Arav0001/navion-dev/(list of files, drawings)

Other design files:
Schematics/CNTRL/freerouting.dsn
Schematics/CNTRL/temp-freerouting.dsn
