Arav0001/navion-dev/Schematics/CNTRL/CNTRL.kicad_pcb

## KiCad design Schematics/CNTRL/CNTRL.kicad_pcb (2025-07-29)

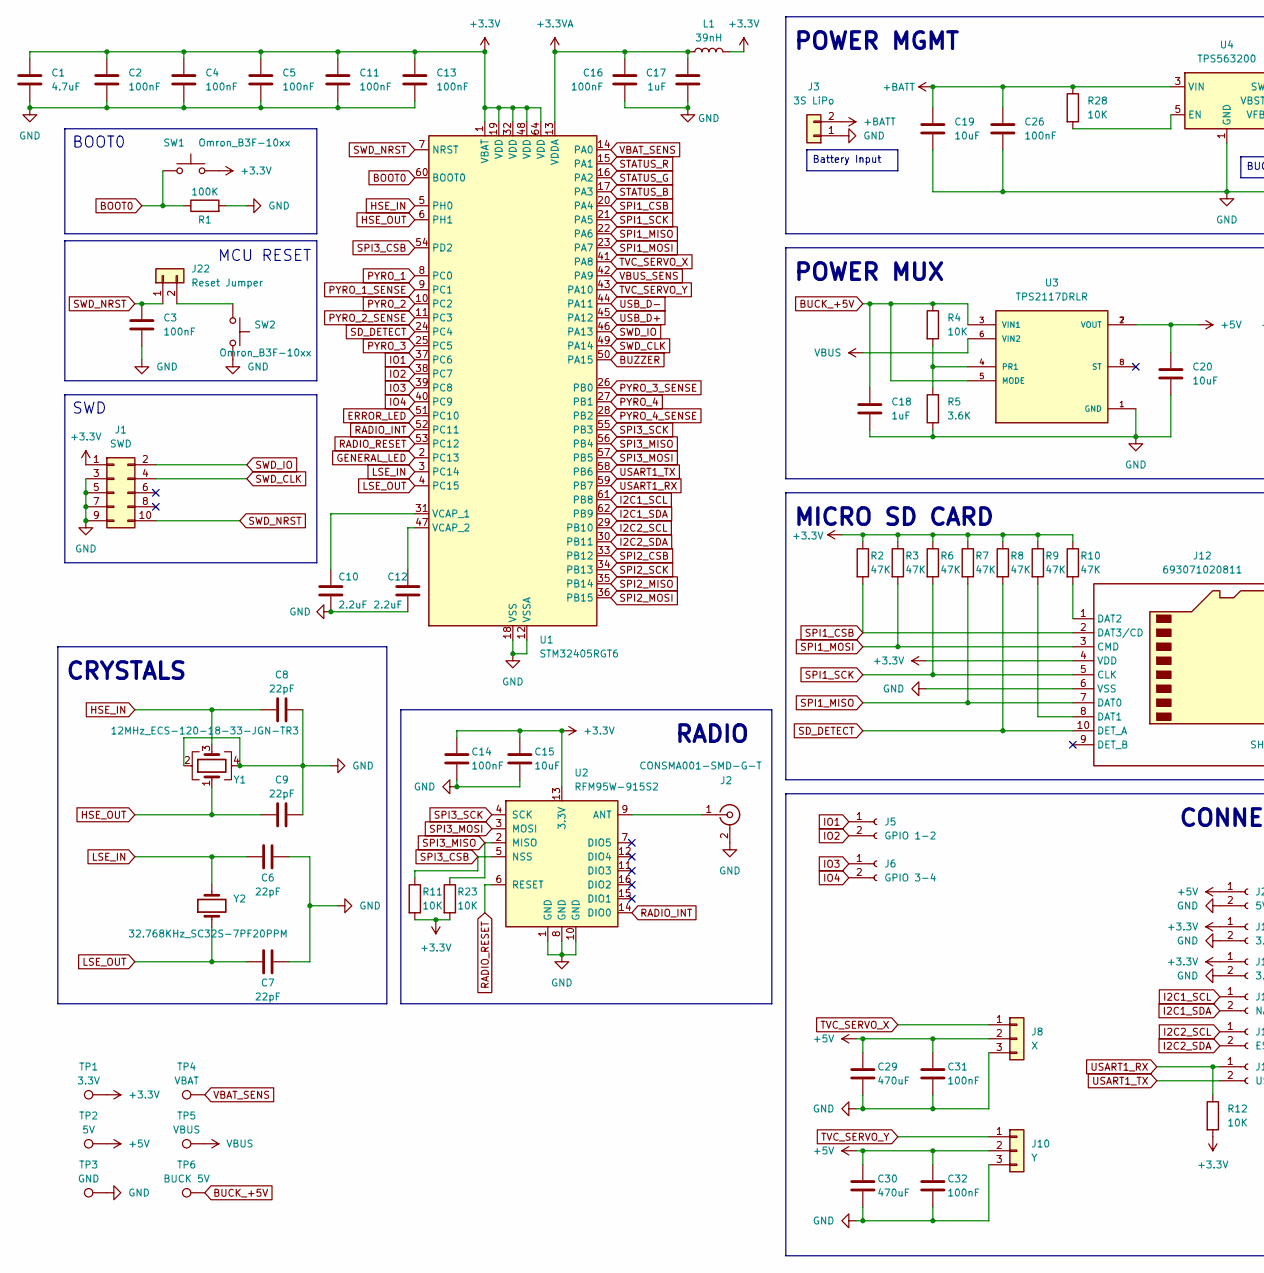
[picture p1: schematic CNTRL.kicad_sch, NAVION CNTRL BOARD SCHEMATIC, part in row 1, column 1]

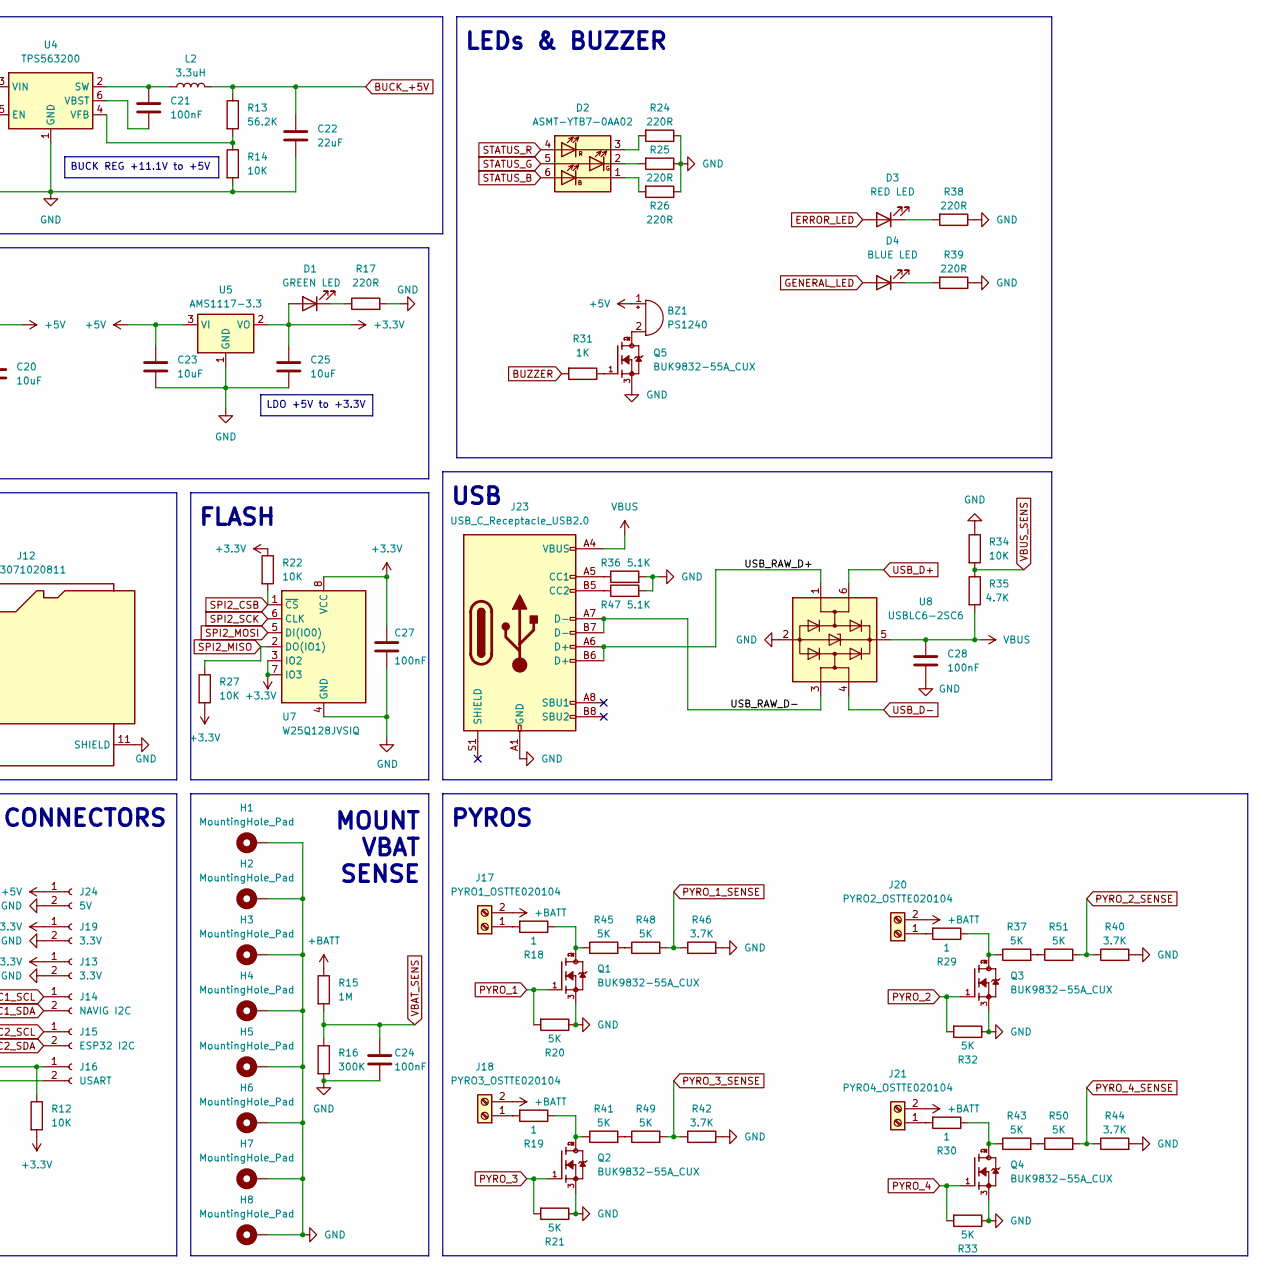
[picture p2: schematic CNTRL.kicad_sch, NAVION CNTRL BOARD SCHEMATIC, part in row 1, column 2]

Parts:
BZ1: PS1240; Buzzer_TDK_PS1240P02BT_D12.2mm_H6.5mm
C1: 4.7uF; C_0603_1608Metric
C2, C3, C4, C5, C11, C13, C14, C16, C21, C24, C26, C27, C28, C31, C32: 100nF; C_0603_1608Metric
C6, C7, C8, C9: 22pF; C_0603_1608Metric
C10, C12: 2.2uF; C_0603_1608Metric
C15, C19, C20, C23, C25: 10uF; C_0603_1608Metric
C17, C18: 1uF; C_0603_1608Metric
C22: 22uF; C_0603_1608Metric
C29, C30: 470uF; CP_Radial_D6.3mm_P2.50mm
D1: GREEN LED; LED_0603_1608Metric
D2: ASMT-YTB7-0AA02; LED_Avago_PLCC6_3x2.8mm
D3: RED LED; LED_0603_1608Metric
D4: BLUE LED; LED_0603_1608Metric
H1, H2, H3, H4, H5, H6, H7, H8: MountingHole_Pad; MountingHole_2.2mm_M2_Pad_TopBottom
J1: SWD; PinHeader_2x05_P1.27mm_Vertical_SMD
J2: CONSMA001-SMD-G-T; LINX_CONSMA001-SMD-G-T
J3: 3S LiPo; AMASS_XT30UPB-M_1x02_P5.0mm_Vertical
J5: GPIO 1-2; TerminalBlock_Phoenix_MPT-0,5-2-2.54_1x02_P2.54mm_Horizontal
J6: GPIO 3-4; TerminalBlock_Phoenix_MPT-0,5-2-2.54_1x02_P2.54mm_Horizontal
J8: X; TerminalBlock_Phoenix_MPT-0,5-3-2.54_1x03_P2.54mm_Horizontal
J10: Y; TerminalBlock_Phoenix_MPT-0,5-3-2.54_1x03_P2.54mm_Horizontal
J12: 693071020811
J13, J19: 3.3V; JST_XH_B2B-XH-A_1x02_P2.50mm_Vertical
J14: NAVIG I2C; JST_XH_B2B-XH-A_1x02_P2.50mm_Vertical
J15: ESP32 I2C; JST_XH_B2B-XH-A_1x02_P2.50mm_Vertical
J16: USART; JST_XH_B2B-XH-A_1x02_P2.50mm_Vertical
J17: PYRO1_OSTTE020104; TerminalBlock_4Ucon_1x02_P3.50mm_Vertical
J18: PYRO3_OSTTE020104; TerminalBlock_4Ucon_1x02_P3.50mm_Vertical
J20: PYRO2_OSTTE020104; TerminalBlock_4Ucon_1x02_P3.50mm_Vertical
J21: PYRO4_OSTTE020104; TerminalBlock_4Ucon_1x02_P3.50mm_Vertical
J22: Reset Jumper; PinHeader_1x02_P2.54mm_Vertical
J23: USB_C_Receptacle_USB2.0; USB_C_Receptacle_GCT_USB4105-xx-A_16P_TopMnt_Horizontal
J24: 5V; JST_XH_B2B-XH-A_1x02_P2.50mm_Vertical
L1: 39nH; L_0603_1608Metric
L2: 3.3uH; L_1210_3225Metric_Pad1.42x2.65mm_HandSolder
Q1, Q2, Q3, Q4, Q5: BUK9832-55A_CUX; TRANS_BUK9832-55A_CUX; PARTREV 02
R1: 100K; R_0603_1608Metric
R2, R3, R6, R7, R8, R9, R10: 47K; R_0603_1608Metric
R4, R11, R12, R14, R22, R23, R27, R28, R34: 10K; R_0603_1608Metric
R5: 3.6K; R_0603_1608Metric
R13: 56.2K; R_0603_1608Metric
R15: 1M; R_0603_1608Metric
R16: 300K; R_0603_1608Metric
R17, R24, R25, R26, R38, R39: 220R; R_0603_1608Metric
R18, R19, R29, R30: 1; R_0603_1608Metric
R20, R21, R32, R33, R37, R41, R43, R45, R48, R49, R50, R51: 5K; R_0603_1608Metric
R31: 1K; R_0603_1608Metric
R35: 4.7K; R_0603_1608Metric
R36, R47: 5.1K; R_0603_1608Metric
R40, R42, R44, R46: 3.7K; R_0603_1608Metric
SW1, SW2: Omron_B3F-10xx; SW_TH_Tactile_Omron_B3F-10xx
TP1: 3.3V; TestPoint_Pad_D2.0mm
TP2: 5V; TestPoint_Pad_D2.0mm
TP3: GND; TestPoint_Pad_D2.0mm
TP4: VBAT; TestPoint_Pad_D2.0mm
TP5: VBUS; TestPoint_Pad_D2.0mm
TP6: BUCK 5V; TestPoint_Pad_D2.0mm
U1: STM32405RGT6; LQFP-64_10x10mm_P0.5mm
U2: RFM95W-915S2; HOPERF_RFM9XW_SMD
U3: TPS2117DRLR; SOT-583-8; PARTREV A
U4: TPS563200; SOT-23-6
U5: AMS1117-3.3; SOT-223-3_TabPin2
U7: W25Q128JVSIQ; SOIC-8_5.3x5.3mm_P1.27mm
U8: USBLC6-2SC6; SOT-23-6
Y1: 12MHz_ECS-120-18-33-JGN-TR3; Crystal_SMD_3225-4Pin_3.2x2.5mm
Y2: 32.768KHz_SC32S-7PF20PPM; Crystal_SMD_3215-2Pin_3.2x1.5mm

Connections:
+3.3V: C1.1, C2.1, C4.1, C5.1, C11.1, C13.1, C14.2, C15.2, C25.1, C27.1, D1.2 (A), J1.1, J12.4 (VDD), J13.1, J19.1, L1.1, R2.1, R3.1, R6.1, R7.1, R8.1, R9.1, R10.1, R11.2, R12.2, R22.1, R23.2, R27.2, SW1.2, TP1.1, U1.1 (VBAT), U1.19 (VDD), U1.32 (VDD), U1.48 (VDD), U1.64 (VDD), U2.13 (3.3V), U5.2 (VO), U7.3 (IO2), U7.7 (IO3), U7.8 (VCC)
+3.3VA: C16.1, C17.1, L1.2, U1.13 (VDDA)
+5V: BZ1.1 (-), C20.1, C23.1, C29.2, C30.2, C31.2, C32.2, J8.2, J10.2, J24.1, TP2.1, U3.2 (VOUT), U3.7 (VOUT), U5.3 (VI)
+BATT: C19.1, C26.1, J3.2, J17.2, J18.2, J20.2, J21.2, R15.1, R28.1, U4.3 (VIN)
/USB_RAW_D+: J23.A6 (D+), J23.B6 (D+), U8.1 (I/O1)
/USB_RAW_D-: J23.A7 (D-), J23.B7 (D-), U8.3 (I/O2)
BOOT0: R1.1, SW1.1, U1.60 (BOOT0)
BUCK_+5V: C18.1, C22.1, L2.2, R4.1, R13.1, TP6.1, U3.3 (VIN1), U3.5 (MODE)
BUZZER: R31.2, U1.50 (PA15)
ERROR_LED: D3.2 (A), U1.51 (PC10)
GENERAL_LED: D4.2 (A), U1.2 (PC13)
GND: C1.2, C2.2, C3.2, C4.2, C5.2, C6.2, C7.2, C8.1, C9.2, C10.1, C11.2, C12.1, C13.2, C14.1, C15.1, C16.2, C17.2, C18.2, C19.2, C20.2, C22.2, C23.2, C24.1, C25.2, C26.2, C27.2, C28.2, C29.1, C30.1, C31.1, C32.1, H1.1, H2.1, H3.1, H4.1, H5.1, H6.1, H7.1, H8.1, J1.3, J1.5, J1.7, J1.9, J2.2 (Ext), J3.1, J8.3, J10.3, J12.6 (VSS), J12.11 (SHIELD), J13.2, J19.2, J23.A1 (GND), J23.A12 (GND), J23.B1 (GND), J23.B12 (GND), J24.2, Q1.3, Q2.3, Q3.3, Q4.3, Q5.3, R1.2, R5.1, R14.2, R16.2, R17.2, R20.1, R21.1, R24.1, R25.1, R26.1, R32.1, R33.1, R34.1, R36.2, R38.1, R39.1, R40.2, R42.2, R44.2, R46.2, R47.2, SW2.2, TP3.1, U1.12 (VSSA), U1.18 (VSS), U1.63 (VSS), U2.1 (GND), U2.8 (GND), U2.10 (GND), U3.1 (GND), U4.1 (GND), U5.1 (GND), U7.4 (GND), U8.2 (GND), Y1.2, Y1.4
HSE_IN: C8.2, U1.5 (PH0), Y1.3
HSE_OUT: C9.1, U1.6 (PH1), Y1.1
I2C1_SCL: J14.1, U1.61 (PB8)
I2C1_SDA: J14.2, U1.62 (PB9)
I2C2_SCL: J15.1, U1.29 (PB10)
I2C2_SDA: J15.2, U1.30 (PB11)
IO1: J5.1, U1.37 (PC6)
IO2: J5.2, U1.38 (PC7)
IO3: J6.1, U1.39 (PC8)
IO4: J6.2, U1.40 (PC9)
LSE_IN: C6.1, U1.3 (PC14), Y2.2
LSE_OUT: C7.1, U1.4 (PC15), Y2.1
unnamed: BZ1.2 (+), Q5.2, Q5.4
unnamed: D1.1 (K), R17.1
unnamed: D2.1 (KB), R26.2
unnamed: D2.2 (KG), R25.2
unnamed: D2.3 (KR), R24.2
unnamed: D3.1 (K), R38.2
unnamed: D4.1 (K), R39.2
unnamed: J2.1 (In), U2.9 (ANT)
unnamed: J12.8 (DAT1), R9.2
unnamed: J12.1 (DAT2), R10.2
unnamed: J17.1, R18.2
unnamed: J18.1, R19.2
unnamed: J20.1, R29.2
unnamed: J21.1, R30.2
unnamed: J22.2, SW2.1
unnamed: J23.A5 (CC1), R36.1
unnamed: J23.B5 (CC2), R47.1
unnamed: Q1.2, Q1.4, R18.1, R45.1
unnamed: Q2.2, Q2.4, R19.1, R41.1
unnamed: Q3.2, Q3.4, R29.1, R37.1
unnamed: Q4.2, Q4.4, R30.1, R43.1
unnamed: Q5.1, R31.1
unnamed: R37.2, R51.1
unnamed: R41.2, R49.1
unnamed: R43.2, R50.1
unnamed: R45.2, R48.1
unnamed: C10.2, U1.31 (VCAP_1)
unnamed: C12.2, U1.47 (VCAP_2)
unnamed: R4.2, R5.2, U3.4 (PR1)
unnamed: R28.2, U4.5 (EN)
unnamed: C21.1, L2.1, U4.2 (SW)
unnamed: C21.2, U4.6 (VBST)
unnamed: R13.2, R14.1, U4.4 (VFB)
PYRO_1: Q1.1, R20.2, U1.8 (PC0)
PYRO_1_SENSE: R46.1, R48.2, U1.9 (PC1)
PYRO_2: Q3.1, R32.2, U1.10 (PC2)
PYRO_2_SENSE: R40.1, R51.2, U1.11 (PC3)
PYRO_3: Q2.1, R21.2, U1.25 (PC5)
PYRO_3_SENSE: R42.1, R49.2, U1.26 (PB0)
PYRO_4: Q4.1, R33.2, U1.27 (PB1)
PYRO_4_SENSE: R44.1, R50.2, U1.28 (PB2)
RADIO_INT: U1.52 (PC11), U2.14 (DIO0)
RADIO_RESET: U1.53 (PC12), U2.6 (RESET)
SD_DETECT: J12.10 (DET_A), R8.2, U1.24 (PC4)
SPI1_CSB: J12.2 (DAT3/CD), R2.2, U1.20 (PA4)
SPI1_MISO: J12.7 (DAT0), R7.2, U1.22 (PA6)
SPI1_MOSI: J12.3 (CMD), R3.2, U1.23 (PA7)
SPI1_SCK: J12.5 (CLK), R6.2, U1.21 (PA5)
SPI2_CSB: R22.2, U1.33 (PB12), U7.1 (~CS)
SPI2_MISO: R27.1, U1.35 (PB14), U7.2 (DO(IO1))
SPI2_MOSI: U1.36 (PB15), U7.5 (DI(IO0))
SPI2_SCK: U1.34 (PB13), U7.6 (CLK)
SPI3_CSB: R11.1, U1.54 (PD2), U2.5 (NSS)
SPI3_MISO: R23.1, U1.56 (PB4), U2.2 (MISO)
SPI3_MOSI: U1.57 (PB5), U2.3 (MOSI)
SPI3_SCK: U1.55 (PB3), U2.4 (SCK)
STATUS_B: D2.6 (AB), U1.17 (PA3)
STATUS_G: D2.5 (AG), U1.16 (PA2)
STATUS_R: D2.4 (AR), U1.15 (PA1)
SWD_CLK: J1.4, U1.49 (PA14)
SWD_IO: J1.2, U1.46 (PA13)
SWD_NRST: C3.1, J1.10, J22.1, U1.7 (NRST)
TVC_SERVO_X: J8.1, U1.41 (PA8)
TVC_SERVO_Y: J10.1, U1.43 (PA10)
USART1_RX: J16.1, R12.1, U1.59 (PB7)
USART1_TX: J16.2, U1.58 (PB6)
USB_D+: U1.45 (PA12), U8.6 (I/O1)
USB_D-: U1.44 (PA11), U8.4 (I/O2)
VBAT_SENS: C24.2, R15.2, R16.1, TP4.1, U1.14 (PA0)
VBUS: C28.1, J23.A4 (VBUS), J23.A9 (VBUS), J23.B4 (VBUS), J23.B9 (VBUS), R35.2, TP5.1, U3.6 (VIN2), U8.5 (VBUS)
VBUS_SENS: R34.2, R35.1, U1.42 (PA9)

Notes on the sheet:
CONNECTORS
PYROS
BOOT0
POWER MUX
SWD
FLASH
LEDs & BUZZER
MCU RESET
MOUNT VBAT SENSE
CRYSTALS
MICRO SD CARD
POWER MGMT
RADIO
USB
Battery Input
LDO +5V to +3.3V
BUCK REG +11.1V to +5V

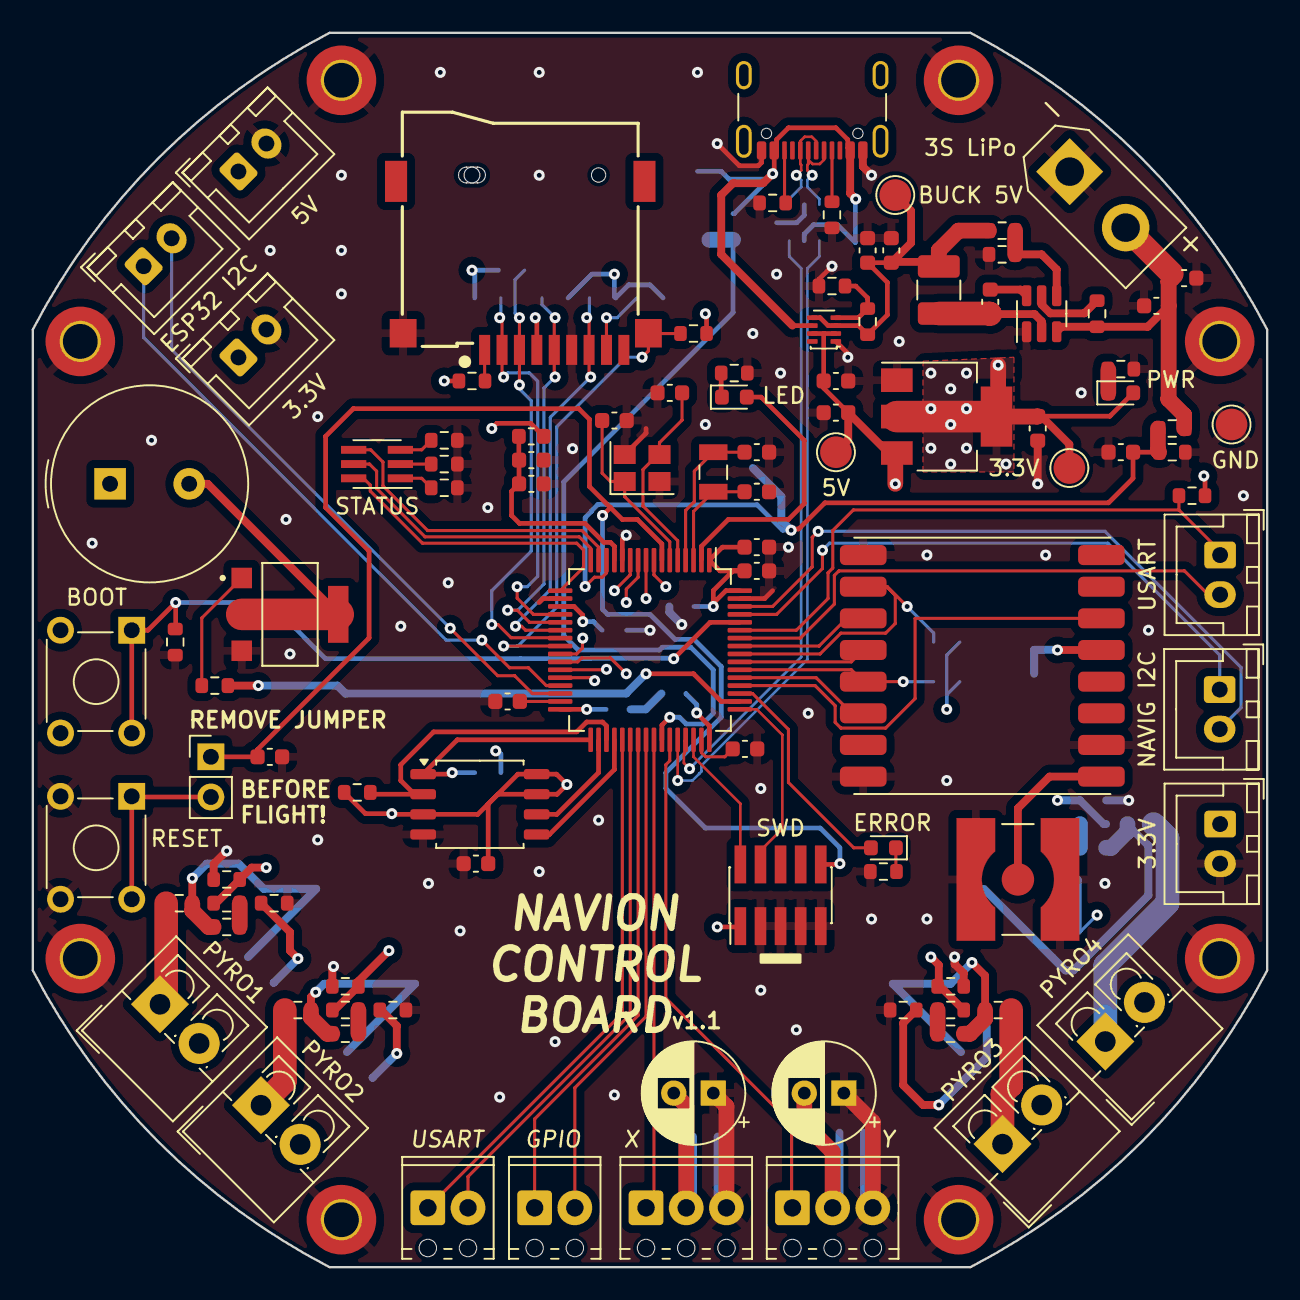
[picture p3: board CNTRL.kicad_pcb from above]

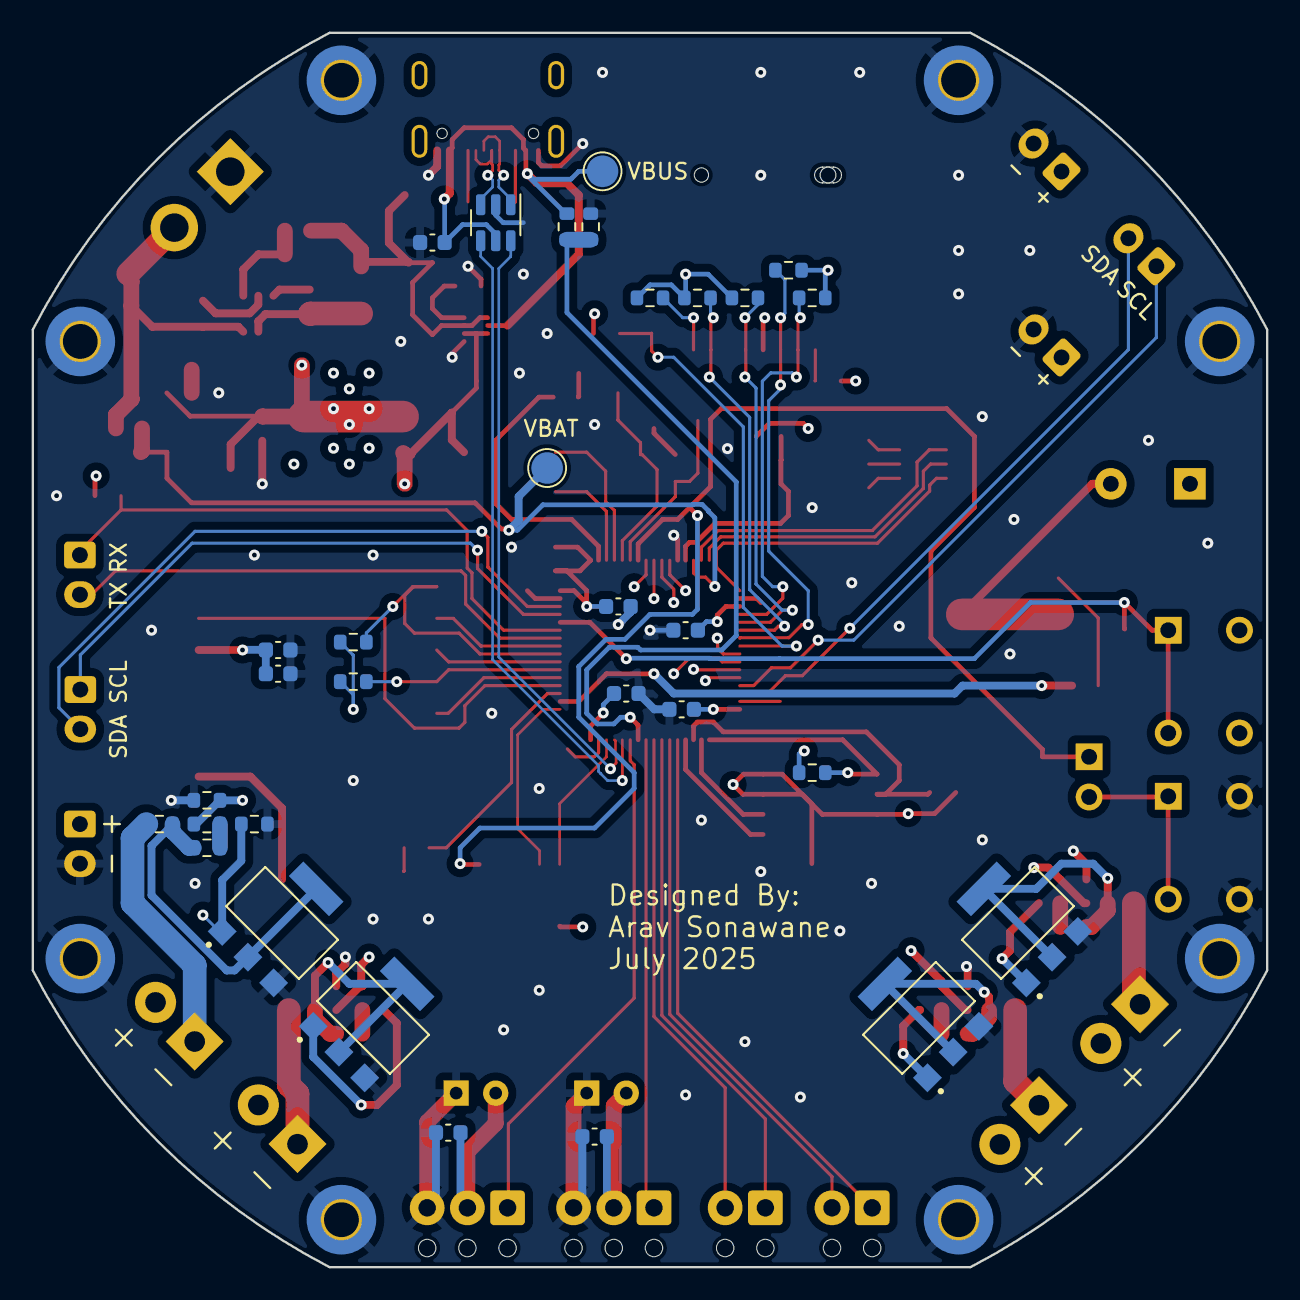
[picture p4: board CNTRL.kicad_pcb from below]

Board: 4 copper layers, 78.0 x 78.0 mm, 140 parts (31 on the bottom side), 95 nets.
