Arav0001/navion-dev/Schematics/NAVIG/NAVIG.kicad_pcb

## KiCad design Schematics/NAVIG/NAVIG.kicad_pcb (2025-07-29)

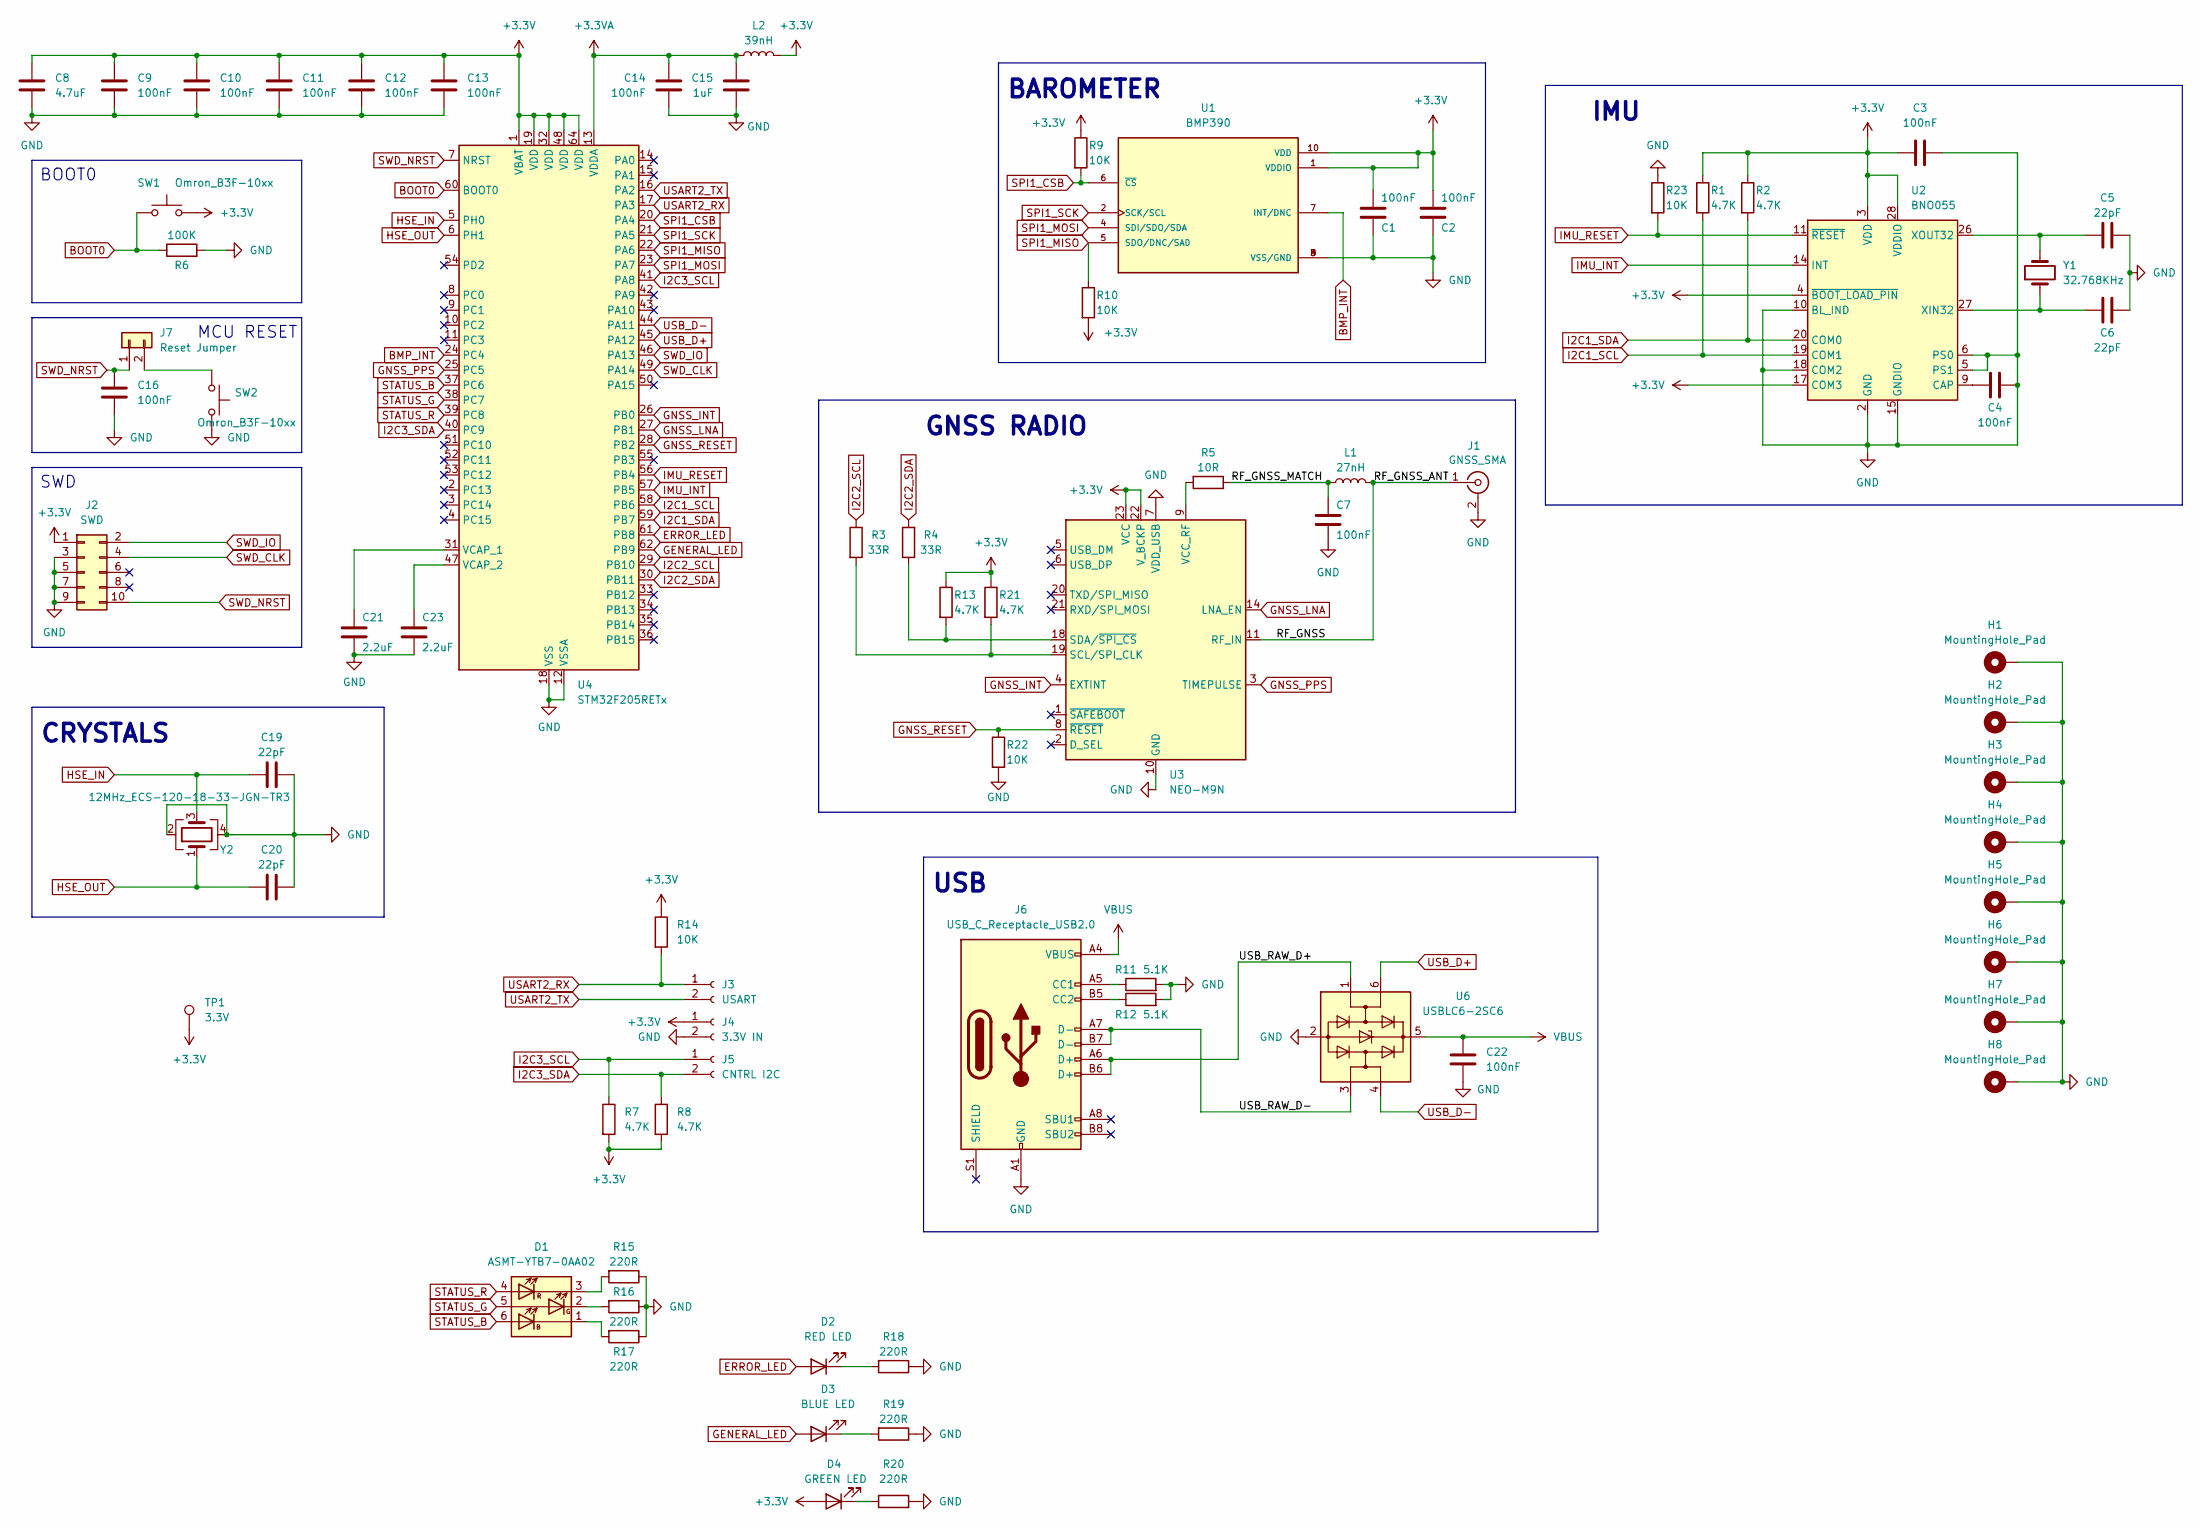
[picture p5: schematic NAVIG.kicad_sch]

Parts:
C1, C2, C3, C4, C7, C9, C10, C11, C12, C13, C14, C16, C22: 100nF; C_0603_1608Metric
C5, C6, C19, C20: 22pF; C_0603_1608Metric
C8: 4.7uF; C_0603_1608Metric
C15: 1uF; C_0603_1608Metric
C21, C23: 2.2uF; C_0603_1608Metric
D1: ASMT-YTB7-0AA02; LED_Avago_PLCC6_3x2.8mm
D2: RED LED; LED_0603_1608Metric
D3: BLUE LED; LED_0603_1608Metric
D4: GREEN LED; LED_0603_1608Metric
H1, H2, H3, H4, H5, H6, H7, H8: MountingHole_Pad; MountingHole_2.2mm_M2_Pad_TopBottom
J1: GNSS_SMA; SMA_Amphenol_132134-10_Vertical
J2: SWD; PinHeader_2x05_P1.27mm_Vertical_SMD
J3: USART; JST_XH_B2B-XH-A_1x02_P2.50mm_Vertical
J4: 3.3V IN; JST_XH_B2B-XH-A_1x02_P2.50mm_Vertical
J5: CNTRL I2C; JST_XH_B2B-XH-A_1x02_P2.50mm_Vertical
J6: USB_C_Receptacle_USB2.0; USB_C_Receptacle_GCT_USB4105-xx-A_16P_TopMnt_Horizontal
J7: Reset Jumper; PinHeader_1x02_P2.54mm_Vertical
L1: 27nH; L_TDK_NLV32_3.2x2.5mm
L2: 39nH; L_0603_1608Metric
R1, R2, R7, R8, R13, R21: 4.7K; R_0603_1608Metric
R3, R4: 33R; R_0603_1608Metric
R5: 10R; R_0603_1608Metric
R6: 100K; R_0603_1608Metric
R9, R10, R14, R22, R23: 10K; R_0603_1608Metric
R11, R12: 5.1K; R_0603_1608Metric
R15, R16, R17, R18, R19, R20: 220R; R_0603_1608Metric
SW1, SW2: Omron_B3F-10xx; SW_TH_Tactile_Omron_B3F-10xx
TP1: 3.3V; TestPoint_Pad_D2.0mm
U1: BMP390; XDCR_BMP390L; PARTREV 1.7
U2: BNO055; LGA-28_5.2x3.8mm_P0.5mm
U3: NEO-M9N; ublox_NEO
U4: STM32F205RETx; LQFP-64_10x10mm_P0.5mm
U6: USBLC6-2SC6; SOT-23-6
Y1: 32.768KHz; Crystal_SMD_3215-2Pin_3.2x1.5mm
Y2: 12MHz_ECS-120-18-33-JGN-TR3; Crystal_SMD_3225-4Pin_3.2x2.5mm

Connections:
+3.3V: C1.1, C2.1, C3.2, C8.1, C9.1, C10.1, C11.1, C12.1, C13.1, D4.2 (A), J2.1, J4.1, L2.1, R1.1, R2.1, R7.2, R8.2, R9.1, R10.2, R13.1, R14.1, R21.1, SW1.2, TP1.1, U1.1 (VDDIO), U1.10 (VDD), U2.3 (VDD), U2.4 (~BOOT_LOAD_PIN), U2.17 (COM3), U2.28 (VDDIO), U3.22 (V_BCKP), U3.23 (VCC), U4.1 (VBAT), U4.19 (VDD), U4.32 (VDD), U4.48 (VDD), U4.64 (VDD)
+3.3VA: C14.1, C15.1, L2.2, U4.13 (VDDA)
/RF_GNSS: J1.1 (In), L1.1, U3.11 (RF_IN)
/RF_GNSS_MATCH: C7.1, L1.2, R5.1
/USB_RAW_D+: J6.A6 (D+), J6.B6 (D+), U6.1 (I/O1)
/USB_RAW_D-: J6.A7 (D-), J6.B7 (D-), U6.3 (I/O2)
BMP_INT: U1.7 (INT/DNC), U4.24 (PC4)
BOOT0: R6.1, SW1.1, U4.60 (BOOT0)
ERROR_LED: D2.2 (A), U4.61 (PB8)
GENERAL_LED: D3.2 (A), U4.62 (PB9)
GND: C1.2, C2.2, C3.1, C4.1, C5.2, C6.2, C7.2, C8.2, C9.2, C10.2, C11.2, C12.2, C13.2, C14.2, C15.2, C16.2, C19.1, C20.2, C21.1, C22.2, C23.1, H1.1, H2.1, H3.1, H4.1, H5.1, H6.1, H7.1, H8.1, J1.2 (Ext), J2.3, J2.5, J2.7, J2.9, J4.2, J6.A1 (GND), J6.A12 (GND), J6.B1 (GND), J6.B12 (GND), R6.2, R11.2, R12.2, R15.1, R16.1, R17.1, R18.1, R19.1, R20.2, R22.2, R23.1, SW2.2, U1.3 (VSS/GND), U1.8 (VSS/GND), U1.9 (VSS/GND), U2.2 (GND), U2.5 (PS1), U2.6 (PS0), U2.10 (BL_IND), U2.15 (GNDIO), U2.16 (GNDIO), U2.18 (COM2), U2.25 (GNDIO), U3.7 (VDD_USB), U3.10 (GND), U3.12 (GND), U3.13 (GND), U3.24 (GND), U4.12 (VSSA), U4.18 (VSS), U4.63 (VSS), U6.2 (GND), Y2.2, Y2.4
GNSS_INT: U3.4 (EXTINT), U4.26 (PB0)
GNSS_LNA: U3.14 (LNA_EN), U4.27 (PB1)
GNSS_PPS: U3.3 (TIMEPULSE), U4.25 (PC5)
GNSS_RESET: R22.1, U3.8 (~RESET), U4.28 (PB2)
HSE_IN: C19.2, U4.5 (PH0), Y2.3
HSE_OUT: C20.1, U4.6 (PH1), Y2.1
I2C1_SCL: R1.2, U2.19 (COM1), U4.58 (PB6)
I2C1_SDA: R2.2, U2.20 (COM0), U4.59 (PB7)
I2C2_SCL: R3.1, U4.29 (PB10)
I2C2_SDA: R4.2, U4.30 (PB11)
I2C3_SCL: J5.1, R7.1, U4.41 (PA8)
I2C3_SDA: J5.2, R8.1, U4.40 (PC9)
IMU_INT: U2.14 (INT), U4.57 (PB5)
IMU_RESET: R23.2, U2.11 (~RESET), U4.56 (PB4)
unnamed: D1.1 (KB), R17.2
unnamed: D1.2 (KG), R16.2
unnamed: D1.3 (KR), R15.2
unnamed: D2.1 (K), R18.2
unnamed: D3.1 (K), R19.2
unnamed: D4.1 (K), R20.1
unnamed: J6.A5 (CC1), R11.1
unnamed: J6.B5 (CC2), R12.1
unnamed: J7.2, SW2.1
unnamed: C4.2, U2.9 (CAP)
unnamed: C6.1, U2.27 (XIN32), Y1.1
unnamed: C5.1, U2.26 (XOUT32), Y1.2
unnamed: R3.2, R21.2, U3.19 (SCL/SPI_CLK)
unnamed: R4.1, R13.2, U3.18 (SDA/~SPI_CS)
unnamed: R5.2, U3.9 (VCC_RF)
unnamed: C21.2, U4.31 (VCAP_1)
unnamed: C23.2, U4.47 (VCAP_2)
SPI1_CSB: R9.2, U1.6 (~CS), U4.20 (PA4)
SPI1_MISO: R10.1, U1.5 (SDO/DNC/SA0), U4.22 (PA6)
SPI1_MOSI: U1.4 (SDI/SDO/SDA), U4.23 (PA7)
SPI1_SCK: U1.2 (SCK/SCL), U4.21 (PA5)
STATUS_B: D1.6 (AB), U4.37 (PC6)
STATUS_G: D1.5 (AG), U4.38 (PC7)
STATUS_R: D1.4 (AR), U4.39 (PC8)
SWD_CLK: J2.4, U4.49 (PA14)
SWD_IO: J2.2, U4.46 (PA13)
SWD_NRST: C16.1, J2.10, J7.1, U4.7 (NRST)
USART2_RX: J3.1, R14.2, U4.17 (PA3)
USART2_TX: J3.2, U4.16 (PA2)
USB_D+: U4.45 (PA12), U6.6 (I/O1)
USB_D-: U4.44 (PA11), U6.4 (I/O2)
VBUS: C22.1, J6.A4 (VBUS), J6.A9 (VBUS), J6.B4 (VBUS), J6.B9 (VBUS), U6.5 (VBUS)

Notes on the sheet:
IMU
GNSS RADIO
SWD
USB
CRYSTALS
BOOT0
MCU RESET
BAROMETER

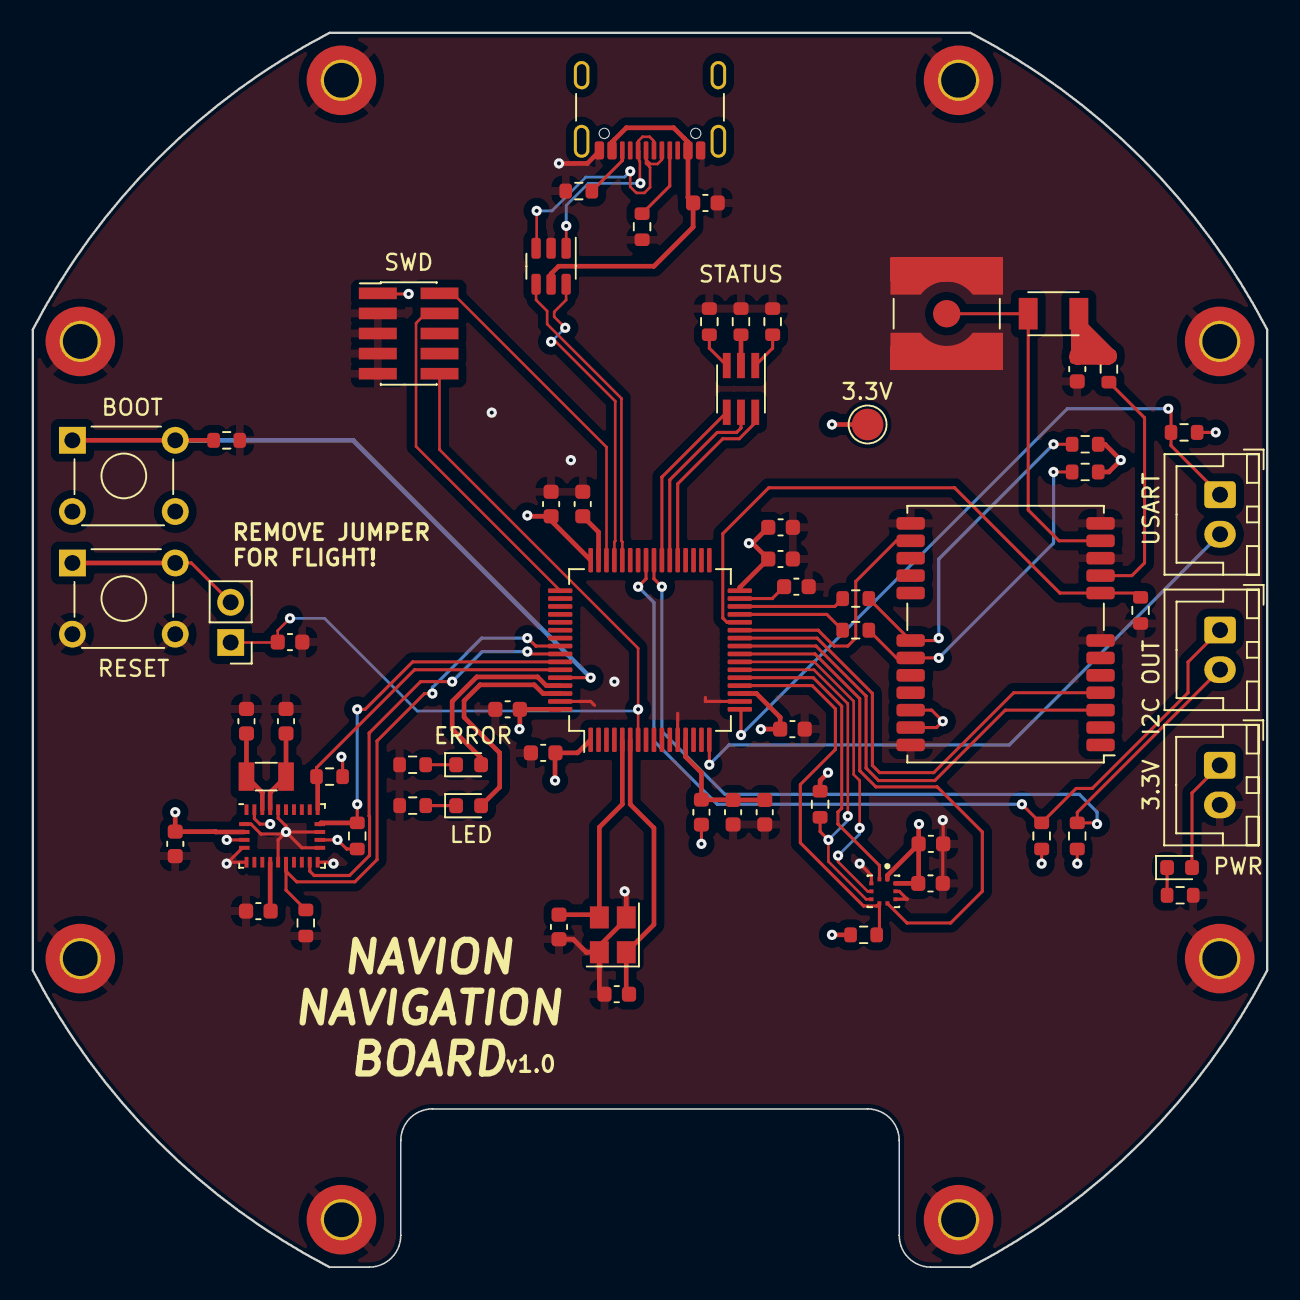
[picture p6: board NAVIG.kicad_pcb from above]

Board: 4 copper layers, 78.0 x 78.0 mm, 75 parts (0 on the bottom side), 57 nets.
