Arav0001/navion-dev/Code/CNTRL/Core/Src/main.c

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
/* Includes ------------------------------------------------------------------*/
#include "main.h"
#include "fatfs.h"
#include "usb_device.h"

/* USER CODE BEGIN Includes */
#include "config.h"
#include "util.h"

#include "usbd_cdc_if.h"

#include "Drivers/pwm.h"
#include "Drivers/led.h"
#include "Drivers/servo.h"
#include "Drivers/pyro.h"
#include "Drivers/w25qxx.h"
#include "Drivers/buzzer.h"

#include "uart_dma.h"
#include "logger.h"
#include "calibration.h"
#include "orientation.h"
#include "tvc.h"
#include "control.h"
#include "battery.h"
#include "esp32.h"
#include "flight.h"
/* USER CODE END Includes */

ADC_HandleTypeDef hadc1;
DMA_HandleTypeDef hdma_adc1;

CRC_HandleTypeDef hcrc;

I2C_HandleTypeDef hi2c1;
I2C_HandleTypeDef hi2c2;

SPI_HandleTypeDef hspi1;
SPI_HandleTypeDef hspi2;
SPI_HandleTypeDef hspi3;

TIM_HandleTypeDef htim1;
TIM_HandleTypeDef htim2;
TIM_HandleTypeDef htim6;
TIM_HandleTypeDef htim7;

UART_HandleTypeDef huart1;
DMA_HandleTypeDef hdma_usart1_rx;

/* USER CODE BEGIN PV */
/* STATUS LED */
rgb_led status_led = {
	.r_pwm = {
		.htim = &htim2,
		.channel = TIM_CHANNEL_2,
		.resolution = 255
	},
	.g_pwm = {
		.htim = &htim2,
		.channel = TIM_CHANNEL_3,
		.resolution = 255
	},
	.b_pwm = {
		.htim = &htim2,
		.channel = TIM_CHANNEL_4,
		.resolution = 255
	}
};

/* TVC */
tvc_mount tvc = {
	.x = {
		.config = {
			.MAX_ANGLE = 90.0f,
			.INIT_ANGLE = SERVO_DEFAULT_INIT_ANGLE,
			.MIN_PW = SERVO_DEFAULT_MIN_PW,
			.MAX_PW = SERVO_DEFAULT_MAX_PW,
			.PERIOD = SERVO_DEFAULT_PERIOD,
			.DIRECTION = SERVO_POSITIVE
		},
		.pwm = {
			.htim = &htim1,
			.channel = TIM_CHANNEL_1,
			.resolution = SERVO_GET_PWM_RESOLUTION(1000000, SERVO_DEFAULT_PERIOD)
		}
	},
	.y = {
		.config = {
			.MAX_ANGLE = 90.0f,
			.INIT_ANGLE = SERVO_DEFAULT_INIT_ANGLE,
			.MIN_PW = SERVO_DEFAULT_MIN_PW,
			.MAX_PW = SERVO_DEFAULT_MAX_PW,
			.PERIOD = SERVO_DEFAULT_PERIOD,
			.DIRECTION = SERVO_POSITIVE
		},
		.pwm = {
			.htim = &htim1,
			.channel = TIM_CHANNEL_3,
			.resolution = SERVO_GET_PWM_RESOLUTION(1000000, SERVO_DEFAULT_PERIOD)
		}
	},
	.pid_x = {
		.Kp = 0.5f,
		.Ki = 0.0f,
		.Kd = 0.005f,
		.Ka = 0.85f,
		.OUT_MAX = 5.0f,
		.OUT_MIN = -5.0f,
	},
	.pid_y = {
		.Kp = 0.5f,
		.Ki = 0.0f,
		.Kd = 0.005f,
		.Ka = 0.85f,
		.OUT_MAX = 5.0f,
		.OUT_MIN = -5.0f,
	}
};

/* PYROS */
pyro parachute = {
	.pyro_port = PYRO_4_GPIO_Port,
	.pyro_pin = PYRO_4_Pin,
	.cont_port = PYRO_4_SENSE_GPIO_Port,
	.cont_pin = PYRO_4_SENSE_Pin,
	.fire_duration = 1000
};

buzzer bzr = {
	.pwm = {
		.htim = &htim2,
		.channel = TIM_CHANNEL_1,
		.resolution = 255
	}
};

/* LOGGER */
rocket_data r_data = {0};
float vbat;

uint32_t last_log_ms = 0;

/* QUATERNION USB CDC */
//uint8_t quat_buffer[4 * sizeof(float)];
//
//uint32_t last_send_time = 0;  // ms
//const uint32_t send_interval = 50; // ms

/* CONTROL */
sensor_data data = {0};
float orientation_quat[4] = {0};

float roll;
float pitch;
float yaw;

/* STATE */
flight_FSM flight = {0};

/* CALIBRATION */
#ifdef CALIBRATE
extern uint8_t acc_calibrated;
extern int gyr_calibrated;
#endif

#ifdef CALIBRATE_ACC
extern MAC_output_t acc_cal;
MAC_output_t calib_acc;
#endif

#ifdef CALIBRATE_GYR
extern MGC_output_t gyr_cal;
MGC_output_t calib_gyr;
#endif

#ifdef CALIBRATE_MAG
extern MMC_Output_t mag_cal;
MMC_Output_t calib_mag;
#endif

/* USER CODE END PV */

void SystemClock_Config(void);
static void MX_GPIO_Init(void);
static void MX_DMA_Init(void);
static void MX_TIM2_Init(void);
static void MX_I2C1_Init(void);
static void MX_SPI2_Init(void);
static void MX_USART1_UART_Init(void);
static void MX_CRC_Init(void);
static void MX_TIM1_Init(void);
static void MX_ADC1_Init(void);
static void MX_I2C2_Init(void);
static void MX_SPI1_Init(void);
static void MX_TIM7_Init(void);
static void MX_TIM6_Init(void);
static void MX_SPI3_Init(void);
/* USER CODE BEGIN 0 */
void HAL_TIM_PeriodElapsedCallback(TIM_HandleTypeDef *htim) {
	if (htim->Instance == TIM7) {
#ifdef CALIBRATE_ACC
		run_acc_calibration();
    	calib_acc = acc_cal;
#endif
#ifdef CALIBRATE_GYR
		run_gyr_calibration();
    	calib_gyr = gyr_cal;
#endif
#ifdef CALIBRATE_MAG
		run_mag_calibration();
    	calib_mag = mag_cal;
#endif
    }
#ifndef CALIBRATE
	if (htim->Instance == TIM6) {
		calculate_orientation(orientation_quat, flight.vars.quat0, &roll, &pitch, &yaw);
	}
#endif
}

void process_esp32_instruction(esp32_instruction* instruction) {
	if (instruction->type == ESP32_ARM) {
		HAL_GPIO_TogglePin(GENERAL_LED_GPIO_Port, GENERAL_LED_Pin);
		flight.inputs.arm_request = 1;
	} else if (instruction->type == ESP32_TVC_SERVO_X_POS) {
		if (instruction->payload_size == sizeof(float)) {
			float x_angle;
			memcpy(&x_angle, instruction->payload, sizeof(float));

			tvc_set_angle(&tvc, x_angle, TVC_SERVO_X);
		}
	} else if (instruction->type == ESP32_TVC_SERVO_Y_POS) {
		if (instruction->payload_size == sizeof(float)) {
			float y_angle;
			memcpy(&y_angle, instruction->payload, sizeof(float));

			tvc_set_angle(&tvc, y_angle, TVC_SERVO_Y);
		}
	} else if (instruction->type == ESP32_TVC_DEFLECTION_POS) {
		if (instruction->payload_size == 2 * sizeof(float)) {
			float x_angle;
			float y_angle;

			memcpy(&x_angle, instruction->payload, sizeof(float));
			memcpy(&y_angle, instruction->payload + sizeof(float), sizeof(float));

			tvc_set_angles_f(&tvc, x_angle, y_angle);
		}
	}
}

void fill_rocket_data() {
	r_data.T_plus = HAL_GetTick() / 1000.0f;

	r_data.flags.calibrated = flight.flags.calibrated;
	r_data.flags.armed = flight.flags.armed;
	r_data.flags.ignition = flight.flags.ignition;
	r_data.flags.apogee = flight.flags.apogee;
	r_data.flags.touchdown = flight.flags.touchdown;

	r_data.state = flight.state;

	r_data.vbat = vbat;

	r_data.acc.x = data.ax;
	r_data.acc.y = data.ay;
	r_data.acc.z = data.az;

	r_data.gyr.x = data.gx;
	r_data.gyr.y = data.gy;
	r_data.gyr.z = data.gz;

	r_data.mag.x = data.mx;
	r_data.mag.y = data.my;
	r_data.mag.z = data.mz;

	r_data.quat.w = orientation_quat[0];
	r_data.quat.x = orientation_quat[1];
	r_data.quat.y = orientation_quat[2];
	r_data.quat.z = orientation_quat[3];

	r_data.temperature = data.temperature;
	r_data.pressure = data.pressure;
	r_data.altitude = flight.vars.alt;
	r_data.v_velocity = flight.vars.v_vel;
	r_data.v_accel = flight.vars.v_accel;

	r_data.tvc.x = tvc.ax;
	r_data.tvc.y = tvc.ay;

	r_data.pyro.motor = PYRO_BROKEN;
	r_data.pyro.parachute = parachute.state;
}
/* USER CODE END 0 */

/**
  * @brief  The application entry point.
  * @retval int
  */
int main(void)
{

  /* MCU Configuration--------------------------------------------------------*/

  /* Reset of all peripherals, Initializes the Flash interface and the Systick. */
  HAL_Init();

  /* Configure the system clock */
  SystemClock_Config();

  /* Initialize all configured peripherals */
  MX_GPIO_Init();
  MX_DMA_Init();
  MX_FATFS_Init();
  MX_TIM2_Init();
  MX_I2C1_Init();
  MX_SPI2_Init();
  MX_USART1_UART_Init();
  MX_CRC_Init();
  MX_TIM1_Init();
  MX_ADC1_Init();
  MX_I2C2_Init();
  MX_SPI1_Init();
  MX_TIM7_Init();
  MX_USB_DEVICE_Init();
  MX_TIM6_Init();
  MX_SPI3_Init();
  /* USER CODE BEGIN 2 */
  config_load_settings();

  rgb_led_start(&status_led);
  buzzer_init(&bzr);
  battery_adc_start();

  tvc_init(&tvc);

#ifndef CALIBRATE
  pyro_init(&parachute);

  rgb_led_set_color(&status_led, COLOR_PURPLE);

  if (CONFIG_DO_LOGGING) {
	  logger_flash_init();
  }
#endif

  initialize_uart_dma();
  initialize_esp32();

#ifndef CALIBRATE
  HAL_TIM_Base_Start_IT(&htim6);
  initialize_orientation();
#endif

#ifdef CALIBRATE
  HAL_TIM_Base_Start_IT(&htim7);

  initialize_acc_calibration();
  initialize_gyr_calibration();
  initialize_mag_calibration();
#endif

#ifndef CALIBRATE
  tvc_start(&tvc);
  flight_initialize(&flight);
  rgb_led_set_color(&status_led, COLOR_GREEN);
#endif
  /* USER CODE END 2 */

  /* Infinite loop */
  /* USER CODE BEGIN WHILE */
  while (!flight.signals.signal_ready)
  {
    /* USER CODE END WHILE */

    /* USER CODE BEGIN 3 */
	  battery_update_voltage(&vbat);

#ifndef CALIBRATE
	  pyro_update(&parachute);
#endif

	  if (uart_dma_is_data_ready()) {
		  uart_dma_reset_data_ready();

		  // process packet
		  sensor_packet* latest_packet = uart_dma_get_latest_packet();
		  process_raw_sensor_data(&latest_packet->data, &data);

#ifndef CALIBRATE
		  // log new data
		  fill_rocket_data();
		  uint32_t dt = HAL_GetTick() - last_log_ms;
		  if (flight.flags.armed && dt >= CONFIG_LOGGING_INTERVAL && CONFIG_DO_LOGGING) {
			  logger_flash_log_data(&r_data);
			  last_log_ms = HAL_GetTick();
		  }
#endif
	  }
#ifndef CALIBRATE
	  // update TVC
	  if (flight.flags.calibrated) {
		   tvc_update(&tvc, 0.0f, 0.0f, pitch, yaw);
		  rgb_led_set_color(&status_led, COLOR_BLUE);
	  }

	  // calibrate pressure
	  flight_calibrate();
	  flight_set_calibrations(&flight);

	  // update FSM
	  flight_update_vars(&flight);
	  flight_update_state(&flight);

	  // process FSM signals
	  if (flight.signals.deploy_chute) {
		  flight.signals.deploy_chute = 0;
		  pyro_fire(&parachute);
	  }

	  if (flight.signals.log_data) {
		  flight.signals.log_data = 0;

		  buzzer_set_volume(&bzr, 0.9f);

		  if (CONFIG_DO_LOGGING) {

			  HAL_UART_Abort(&huart1);
#ifndef CALIBRATE
			  HAL_TIM_Base_Stop(&htim1);
			  HAL_TIM_Base_Stop(&htim6);
#else
			  HAL_TIM_Base_Stop(&htim7);
#endif
			  logger_copy_flash_to_sd();
		  }

		  flight.inputs.logging_done = 1;
	  }
#endif
  }

  // flight end loop
  while (1) {
	  rgb_led_set_color(&status_led, COLOR_PURPLE);
	  HAL_Delay(500);
	  rgb_led_set_color(&status_led, COLOR_OFF);
	  HAL_Delay(500);
  }
  /* USER CODE END 3 */
}

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
