Arav0001/navion-dev/Code/CNTRL/CNTRL.ioc

Mcu.UserName=STM32F405RGTx
PA0-WKUP.GPIO_Label=VBAT_SENSING
PA0-WKUP.Signal=ADCx_IN0
PA1.GPIO_Label=STATUS_R
PA1.Signal=S_TIM2_CH2
PA10.GPIO_Label=TVC_SERVO_Y
PA10.Signal=S_TIM1_CH3
PA11.Signal=USB_OTG_FS_DM
PA12.Signal=USB_OTG_FS_DP
PA13.Signal=SYS_JTMS-SWDIO
PA14.Signal=SYS_JTCK-SWCLK
PA15.GPIO_Label=BUZZER
PA15.Signal=S_TIM2_CH1_ETR
PA2.GPIO_Label=STATUS_G
PA2.Signal=S_TIM2_CH3
PA3.GPIO_Label=STATUS_B
PA3.Signal=S_TIM2_CH4
PA4.GPIO_Label=SPI1_CSB
PA4.Signal=GPIO_Output
PA5.Signal=SPI1_SCK
PA6.Signal=SPI1_MISO
PA7.Signal=SPI1_MOSI
PA8.GPIO_Label=TVC_SERVO_X
PA8.Signal=S_TIM1_CH1
PB0.GPIO_Label=PYRO_3_SENSE
PB0.Signal=GPIO_Input
PB1.GPIO_Label=PYRO_4
PB1.Signal=GPIO_Output
PB10.Signal=I2C2_SCL
PB11.Signal=I2C2_SDA
PB12.GPIO_Label=SPI2_CSB
PB12.Signal=GPIO_Output
PB13.Signal=SPI2_SCK
PB14.Signal=SPI2_MISO
PB15.Signal=SPI2_MOSI
PB2.GPIO_Label=PYRO_4_SENSE
PB2.Signal=GPIO_Input
PB3.Signal=SPI3_SCK
PB4.Signal=SPI3_MISO
PB5.Signal=SPI3_MOSI
PB6.Signal=USART1_TX
PB7.Signal=USART1_RX
PB8.Signal=I2C1_SCL
PB9.Signal=I2C1_SDA
PC0.GPIO_Label=PYRO_1
PC0.Signal=GPIO_Output
PC1.GPIO_Label=PYRO_1_SENSE
PC1.Signal=GPIO_Input
PC10.GPIO_Label=ERROR_LED
PC10.Signal=GPIO_Output
PC11.GPIO_Label=RADIO_INT
PC11.Signal=GPXTI11
PC12.GPIO_Label=RADIO_RESET
PC12.Signal=GPIO_Output
PC13-ANTI_TAMP.GPIO_Label=GENERAL_LED
PC13-ANTI_TAMP.Signal=GPIO_Output
PC14-OSC32_IN.Signal=RCC_OSC32_IN
PC15-OSC32_OUT.Signal=RCC_OSC32_OUT
PC2.GPIO_Label=PYRO_2
PC2.Signal=GPIO_Output
PC3.GPIO_Label=PYRO_2_SENSE
PC3.Signal=GPIO_Input
PC4.GPIO_Label=SD_DETECT
PC4.Signal=GPIO_Input
PC5.GPIO_Label=PYRO_3
PC5.Signal=GPIO_Output
PD2.GPIO_Label=SPI3_CSB
PD2.Signal=GPIO_Output
PH0-OSC_IN.Signal=RCC_OSC_IN
PH1-OSC_OUT.Signal=RCC_OSC_OUT
