Arav0001/navion-dev/Code/CNTRL/Core/Inc/main.h

#define GENERAL_LED_Pin GPIO_PIN_13
#define GENERAL_LED_GPIO_Port GPIOC
#define PYRO_1_Pin GPIO_PIN_0
#define PYRO_1_GPIO_Port GPIOC
#define PYRO_1_SENSE_Pin GPIO_PIN_1
#define PYRO_1_SENSE_GPIO_Port GPIOC
#define PYRO_2_Pin GPIO_PIN_2
#define PYRO_2_GPIO_Port GPIOC
#define PYRO_2_SENSE_Pin GPIO_PIN_3
#define PYRO_2_SENSE_GPIO_Port GPIOC
#define VBAT_SENSING_Pin GPIO_PIN_0
#define VBAT_SENSING_GPIO_Port GPIOA
#define STATUS_R_Pin GPIO_PIN_1
#define STATUS_R_GPIO_Port GPIOA
#define STATUS_G_Pin GPIO_PIN_2
#define STATUS_G_GPIO_Port GPIOA
#define STATUS_B_Pin GPIO_PIN_3
#define STATUS_B_GPIO_Port GPIOA
#define SPI1_CSB_Pin GPIO_PIN_4
#define SPI1_CSB_GPIO_Port GPIOA
#define SD_DETECT_Pin GPIO_PIN_4
#define SD_DETECT_GPIO_Port GPIOC
#define PYRO_3_Pin GPIO_PIN_5
#define PYRO_3_GPIO_Port GPIOC
#define PYRO_3_SENSE_Pin GPIO_PIN_0
#define PYRO_3_SENSE_GPIO_Port GPIOB
#define PYRO_4_Pin GPIO_PIN_1
#define PYRO_4_GPIO_Port GPIOB
#define PYRO_4_SENSE_Pin GPIO_PIN_2
#define PYRO_4_SENSE_GPIO_Port GPIOB
#define SPI2_CSB_Pin GPIO_PIN_12
#define SPI2_CSB_GPIO_Port GPIOB
#define TVC_SERVO_X_Pin GPIO_PIN_8
#define TVC_SERVO_X_GPIO_Port GPIOA
#define TVC_SERVO_Y_Pin GPIO_PIN_10
#define TVC_SERVO_Y_GPIO_Port GPIOA
#define BUZZER_Pin GPIO_PIN_15
#define BUZZER_GPIO_Port GPIOA
#define ERROR_LED_Pin GPIO_PIN_10
#define ERROR_LED_GPIO_Port GPIOC
#define RADIO_INT_Pin GPIO_PIN_11
#define RADIO_INT_GPIO_Port GPIOC
#define RADIO_RESET_Pin GPIO_PIN_12
#define RADIO_RESET_GPIO_Port GPIOC
#define SPI3_CSB_Pin GPIO_PIN_2
#define SPI3_CSB_GPIO_Port GPIOD
