Arav0001/navion-dev/Code/CNTRL/Core/Inc/orientation.h

/*
 * orientation.h
 *
 *  Created on: Jun 26, 2025
 *      Author: aravs
 */

#ifndef INC_ORIENTATION_H_
#define INC_ORIENTATION_H_

#include "main.h"
#include "MadgwickAHRS/MadgwickAHRS.h"

void initialize_orientation();
void calculate_orientation(float* quaternion, float* quat0, float* roll, float* pitch, float* yaw);

#endif /* INC_ORIENTATION_H_ */
