Arav0001/navion-dev/Code/CNTRL/Core/Inc/util.h

/*
 * util.h
 *
 *  Created on: May 23, 2025
 *      Author: aravs
 */

#ifndef INC_UTIL_H_
#define INC_UTIL_H_

#include <string.h>
#include <math.h>

#include "main.h"

#include "flight.h"

#include "Drivers/servo.h"
#include "Drivers/pyro.h"

#define RAD_TO_DEG 	180.0f / M_PI
#define CONSTANT_g 	9.8067f
#define CONSTANT_R 	287.05f
#define CONSTANT_C2K 	273.15f

#define PACKET_HEADER  0xABCD

typedef struct {
	uint16_t ax;
	uint16_t ay;
	uint16_t az;

	uint16_t gx;
	uint16_t gy;
	uint16_t gz;

	uint16_t mx;
	uint16_t my;
	uint16_t mz;
} __attribute__((packed)) bno055_data;

typedef struct {
    uint64_t pressure;
    int64_t temperature;
} __attribute__((packed)) bmp390_data;

typedef struct {
	uint16_t x;
	uint16_t y;
	uint16_t z;
} __attribute__((packed)) neom9n_data;

typedef struct {
	uint64_t time;

	bno055_data bno055;
	bmp390_data bmp390;
	neom9n_data neom9n;
} __attribute__((packed)) raw_sensor_data;

typedef struct {
	uint16_t header;
	raw_sensor_data data;
	uint32_t crc;
} __attribute__((packed)) sensor_packet;

#define PACKET_SIZE (sizeof(sensor_packet))

typedef struct {
	uint64_t time;

	float ax;
	float ay;
	float az;

	float gx;
	float gy;
	float gz;

	float mx;
	float my;
	float mz;

	float pressure;
	float temperature;
} __attribute__((packed)) sensor_data;

typedef struct {
	float T_plus;

	flight_event_flags flags;
	uint8_t state;

	float vbat;

	struct {
		float x;
		float y;
		float z;
	} acc;

	struct {
		float x;
		float y;
		float z;
	} gyr;

	struct {
		float x;
		float y;
		float z;
	} mag;

	struct {
		float w;
		float x;
		float y;
		float z;
	} quat;

	float temperature;
	float pressure;
	float altitude;
	float v_velocity;
	float v_accel;

	struct {
		float x;
		float y;
	} tvc;

	struct {
		uint8_t motor;
		uint8_t parachute;
	} pyro;
} __attribute__((packed)) rocket_data;

uint32_t calculate_crc32(uint8_t *data, size_t len);

void build_packet(sensor_packet* packet, raw_sensor_data* data);
uint8_t validate_packet(sensor_packet *packet);

void process_raw_sensor_data(raw_sensor_data* raw_data, sensor_data* data);
void bytes_to_packet(uint8_t* bytes, sensor_packet* packet);

const char* pyro_state_to_str(uint8_t state);
const char* flight_state_to_str(uint8_t state);

void quat_normalize(float q[4]);
void quat_conjugate(const float q_in[4], float q_out[4]);
void quat_multiply(const float q1[4], const float q2[4], float q_out[4]);
void quat_relative(const float q0[4], const float q[4], float q_rel[4]);

#endif /* INC_UTIL_H_ */
