Arav0001/navion-dev/(commit log)

2025-01-08 navig board pcb and schematic along with cntrl board edits
    [CNTRL.kicad_pcb, CNTRL.kicad_sch, NAVIG.kicad_pcb, NAVIG.kicad_sch]
2025-01-15 NAVIG v1 fixes and some experimental CNTRL updates for v2
    [CNTRL.kicad_pcb, CNTRL.kicad_sch, NAVIG.kicad_pcb, NAVIG.kicad_sch]
2025-01-29 slight fixes to navig board for final production run
    [CNTRL.kicad_pcb, NAVIG.kicad_pcb, NAVIG.kicad_sch]
2025-02-19 final nav
    [CNTRL.kicad_pcb, NAVIG.kicad_pcb, NAVIG.kicad_sch, bom.csv, designators.csv, positions.csv]
2025-03-24 initial coding/integration
    i2c slave done (kinda doesnt work)
    bno055 done (untested)
    bmp390 done (untested)
    neom9n not done
    w25q128jv done (untested)
    sd card/fatfs not done
    [CNTRL.kicad_pcb, CNTRL.kicad_sch, NAVIG.kicad_pcb, NAVIG.kicad_sch]
2025-04-09 Fix I2C slave on CNTRL
2025-05-26 bmp390 interrupt reception done
    data formatting and unit conversion/compensation remaining for bmp390
2025-05-27 b2b comms good, packets sending
    bno055 not responding, neom9n basic driver setup
2025-05-27 Enable IMU and add packed attribute to struct
2025-06-05 bno055 communication + UART DMA progress
    bno055 communication done
    working on swapping from I2C to UART DMA
    [CNTRL.ioc, NAVIG.ioc, bmp390.h, bno055.c, bno055.h, main.c, neom9n.c, neom9n.h]
2025-06-05 DMA Processing on CNTRL
2025-06-06 DMA code refactoring
2025-06-10 UART DMA + CRC32 done
    fixed circular DMA rx algorithm and swapped to HAL_UARTEx functions
    packets arriving at 115200 baud consistently
    added packet headers and crc32 to locate and verify incoming packets
    [CNTRL.ioc, NAVIG.ioc, bno055.c, bno055.h, main.c, main.h, util.c, util.h]
2025-06-10 BMP390 data compensation done!!
    bmp390 data compensation done in integer math operations due to lack of FPU on NAVIG board (F205), pressure + temp data sending over UART DMA nicely as well
2025-06-25 Added MotionFX sensor fusion for quaternions
    Calibration for acc/gyro/mag still pending,
    bug in DMA UART, packet loss sometimes, need to fix
    [STM32F205RE Development Board.kicad_pcb, STM32F205RE Development Board.kicad_sch, TELEM.kicad_pcb, TELEM.kicad_sch]
2025-06-25 Push of MEM changes and UART DMA tweaks
2025-06-26 No packet left behind!
    Every single received packet is now handled through the UART DMA at 115200 bps
2025-06-26 Fix linker naming bug
    Rename STM32F405RGTx_FLASH.ld to STM32F405RGTX_FLASH.ld
2025-06-26 Refactor UART DMA and orientation calculation into their own files
2025-06-27 PWM and RGB LED drivers completed
    PWM driver completed to pave the way for servo driver
2025-06-29 Servo driver completed
    rough testing on USB VBUS completed
    testing on true battery +5V pending due to board issues
    [CNTRL.ioc, logger.c, logger.h, main.c, main.h, servo.c, servo.h]
2025-06-29 Pyro drivers completed
    Full testing pending
2025-07-01 Calibration framework complete
2025-07-03 CNTRL fixes towards v1.1
    [CNTRL.kicad_pcb, CNTRL.kicad_sch]
2025-07-04 microSD card logging over SPI
    can log full rocket data to microSD card
    todo: SPI over DMA for faster speeds
2025-07-06 SPI Flash Logging Framework
2025-07-06 Ground Control repo setup
2025-07-09 CNTRL v1.1 fixes
    [CNTRL.kicad_pcb, CNTRL.kicad_sch]
2025-07-10 final CNTRL v1.1
    [CNTRL.kicad_pcb, CNTRL.kicad_sch, bom.csv, designators.csv, positions.csv]
2025-07-10 ESP32 project setup
2025-07-10 CNTRL production run
    [CNTRL.kicad_pcb]
2025-07-10 CNTRL v1.1 production
    [CNTRL.kicad_pcb]
2025-07-10 CNTRL v1.1 lck files
    [CNTRL.kicad_pcb]
2025-07-16 LittleFS on ESP32 + Async Webserver
2025-07-17 ESP32 WebSockets
2025-07-18 Fixed servo timer prescaler
    [CNTRL.ioc, main.c]
2025-07-18 ESP32 WebSocket refactoring
2025-07-21 Buzzer driver
2025-07-22 Quick buzzer initialization fix
    [buzzer.c]
2025-07-22 Indicator LEDs
2025-07-22 Battery voltage reading
2025-07-27 ESP32 to CNTRL communication
2025-07-28 Moving Battery ADC callback
2025-07-28 Moving UART DMA callbacks
2025-07-29 Fixing KiCAD 3D Models
    [CNTRL.kicad_pcb, CNTRL.kicad_pcb_bom.csv, CNTRL.kicad_pcb_positions.csv, NAVIG.kicad_pcb, freerouting.dsn, temp-freerouting.dsn]
2025-08-01 Settings file for OTG parameter changing
    todo: get the calibration preprocessors changed to if statements
2025-08-01 Servo angle fix
2025-08-01 Sending servo angles through ESP32
2025-08-03 Operational TVC device
2025-08-07 Some testing with RocketPy
    [AeroTech_G12ST.csv, AeroTech_G12ST_clean.csv]
2025-08-08 Refactoring simulation code to another repo
    [AeroTech_G12ST.csv, AeroTech_G12ST_clean.csv]
2025-08-08 Simple PID code
2025-08-08 Fixing PID loop and adding Ka
    [control.c, control.h]
2025-08-09 Very dumb PID TVC controller
2025-08-11 Altitude Kalman Filter
2025-08-13 Kinda working ESP32 state reception
2025-08-17 Self-tuning variances for Kalman filter
2025-08-24 New calibration values
2025-09-26 Pre-launch Calibration
2025-09-27 Removing Motor Pyro
2025-09-27 Fixes to FSM transitions
    [esp32.h, flight.c, flight.h, main.c, main.cpp, pyro.c, stm32_i2c.h]
2026-08-07 Add maiden flight data
    [NAVION-1_DATA.csv]
