Arav0001/navion-dev/(notices)

Notices in the files:
Code/CNTRL/Core/Src/main.c:
Copyright (c) 2025 STMicroelectronics.
All rights reserved.
